kodokage/RAMER-Project/Docs/Ramer_units_Ip.md

# Ramer 1
Ethernet : 192.168.50.2 <br>
Wlan :  ssh pi@:10.93.160.4 <br>

# Ramer 2
Ethernet : 192.168.50.3

# Ramer 3
Ethernet : 192.168.50.4

Wireless address will change for different wifi connections
