kodokage/RAMER-Project/20260903_160956.jpg

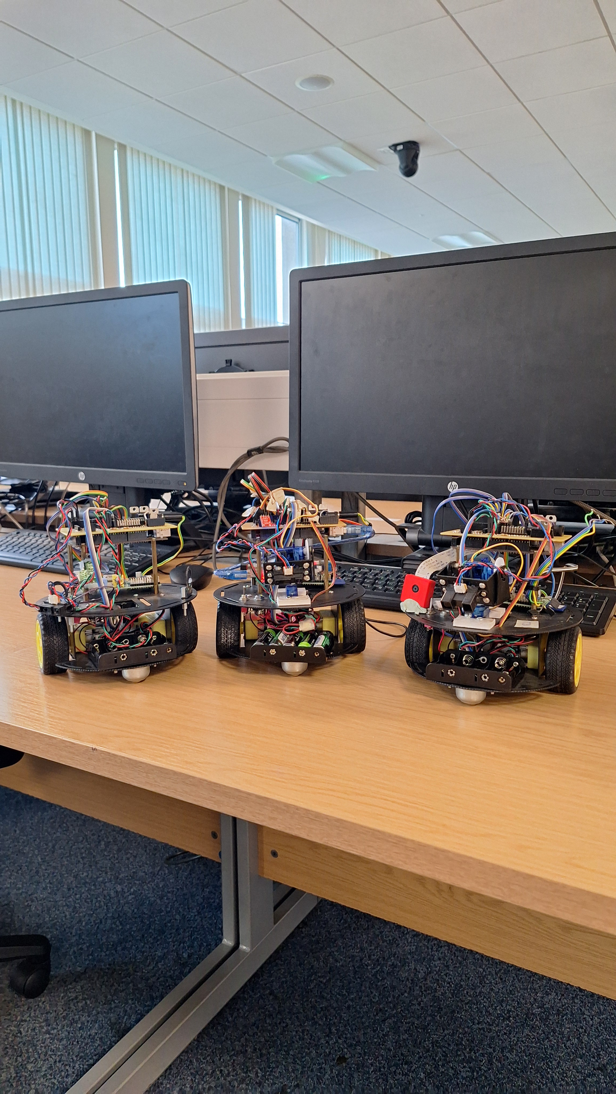
20260903_160956.jpg
