kodokage/RAMER-Project/20260903_161008.jpg

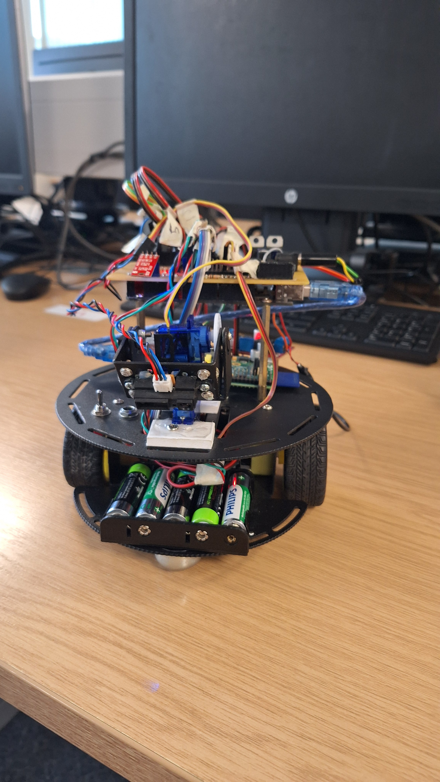
20260903_161008.jpg
