kodokage/RAMER-Project/20260903_161019.jpg

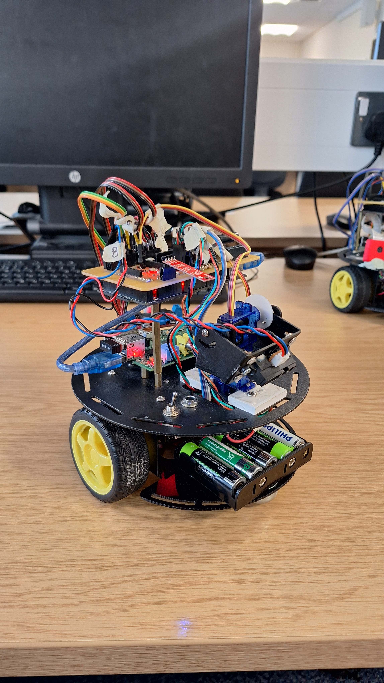
20260903_161019.jpg
