kodokage/RAMER-Project/circuit_diagram.png

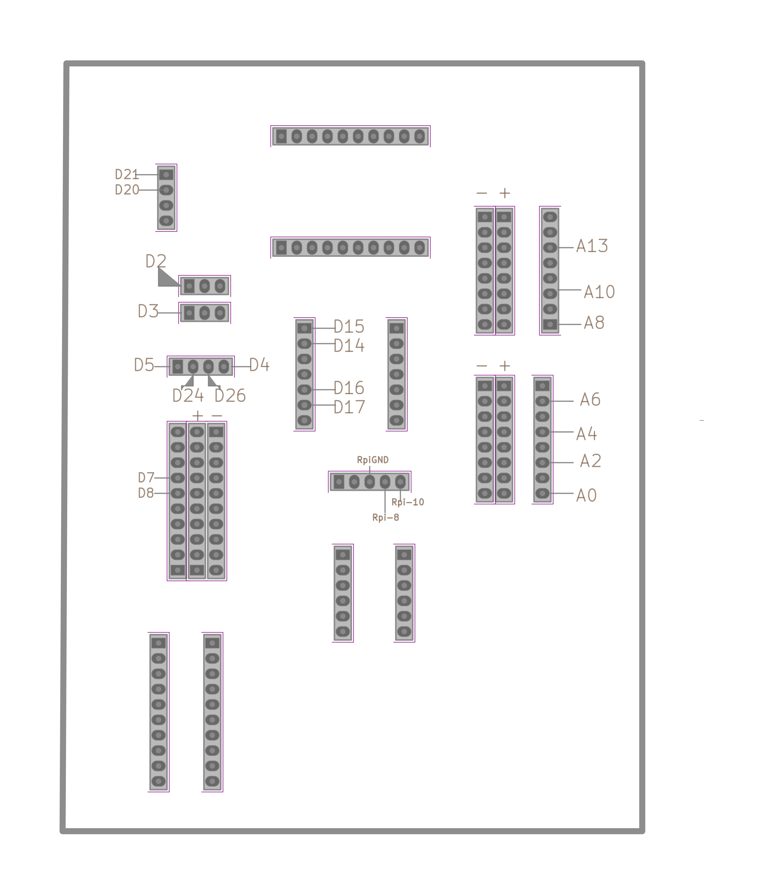
circuit_diagram.png
