kodokage/RAMER-Project/RAMER_Robot_1_1.jpg

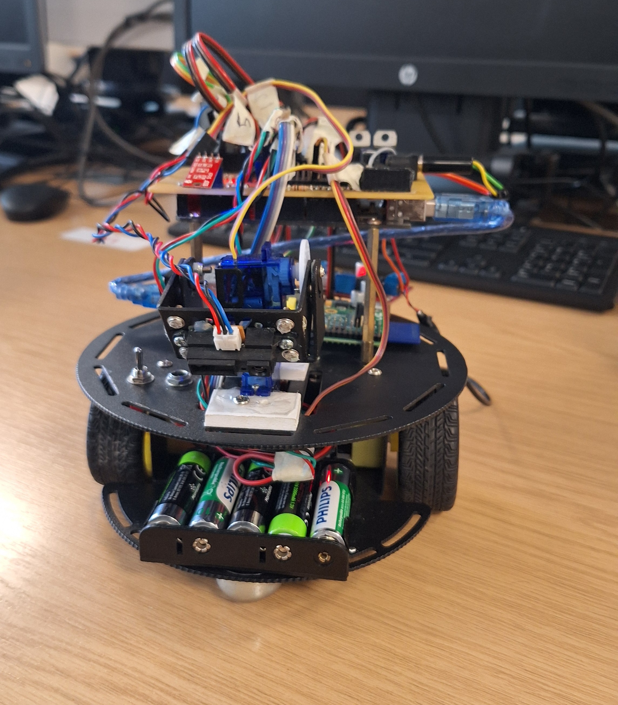
RAMER_Robot_1_1.jpg
