kodokage/RAMER-Project/RAMER_System_Architecture.jpg

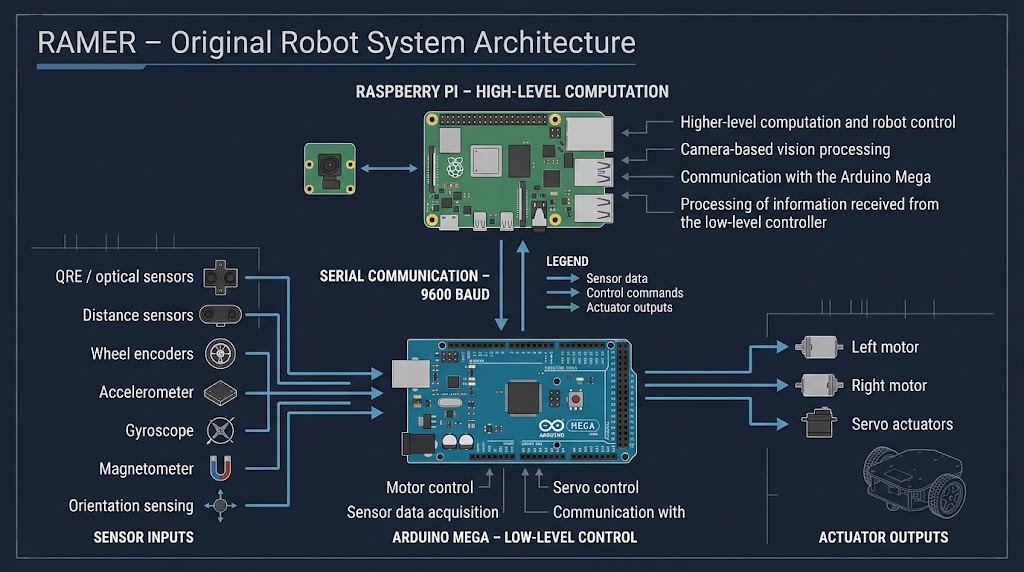
RAMER_System_Architecture.jpg
