kodokage/RAMER-Project/IO_list_BOM.xlsx

Sheet: IO Assignment
S/N | Arduino Mega Pin / Interface | I/O Type | Code Variable | Device | Signal / Function | Configuration / Notes
1 | A0 | Analog input | ir_sensor_1 | QRE1113 #1 | IR line sensor output | analogRead(A0)
2 | A2 | Analog input | ir_sensor_2 | QRE1113 #2 | IR line sensor output | analogRead(A2)
3 | A4 | Analog input | ir_sensor_3 | QRE1113 #3 | IR line sensor output | analogRead(A4)
4 | A6 | Analog input | ir_diode_transistor_1 | OPB706B #1 | IR phototransistor output | analogRead(A6)
5 | A8 | Analog input | ir_diode_transistor_2 | OPB706B #2 | IR phototransistor output | analogRead(A8)
6 | A10 | Analog input | ir_diode_transistor_3 | OPB706B #3 | IR phototransistor output | analogRead(A10)
7 | A13 | Analog input | ir_distance_sensor | Sharp GP2Y0A02YK | IR distance sensor output | ADC converted to distance by sharpDistance()
8 | D7 | Digital output | servo1_pitch | SG90 #1 | Pitch servo control | Servo.attach(7)
9 | D8 | Digital output | servo2_yaw | SG90 #2 | Yaw servo control | Servo.attach(8)
10 | D26 | Digital output | right_motor_fwd | H-bridge / right motor | Right motor direction | HIGH = forward, LOW = reverse
11 | D4 | PWM output | right_motor_speed | H-bridge / right motor | Right motor speed | analogWrite(); +50 software compensation
12 | D24 | Digital output | left_motor_fwd | H-bridge / left motor | Left motor direction | HIGH = forward, LOW = reverse
13 | D5 | PWM output | left_motor_speed | H-bridge / left motor | Left motor speed | analogWrite()
14 | D2 | Digital input / interrupt | right_wheel_encoder | SEN0038 right encoder | Right wheel encoder pulse | INPUT_PULLUP; RISING interrupt
15 | D3 | Digital input / interrupt | left_wheel_encoder | SEN0038 left encoder | Left wheel encoder pulse | INPUT_PULLUP; RISING interrupt
16 | D20 (SDA) | I2C | Wire / IMU | IMU subsystem | I2C data | Wire.begin(); Mega hardware SDA
17 | D21 (SCL) | I2C | Wire / IMU | IMU subsystem | I2C clock | Wire.begin(); Mega hardware SCL
18 | USB / Serial0 | Serial | Serial | Raspberry Pi / host | Command and telemetry interface | 9600 baud

Sheet: BOM
S/N | Item | Description | Qty | Arduino Mega Connection | Pin(s) | Signal / Interface | Code Usage
1 | SG90 9G Micro Servo | 9 g micro servo motor used for pan/tilt positioning. | 2 | Pitch + Yaw servo outputs | D7, D8 | Digital servo control | pitchServo.attach(7); yawServo.attach(8)
2 | Raspberry Pi 2011 | Raspberry Pi Model B used as the higher-level computer/host. | 1 | Serial host interface | USB / Serial0 | Serial | Commands and responses through Serial at 9600 baud
3 | Arduino Mega | Arduino Mega microcontroller used as the main hardware I/O controller. | 1 | Main controller | — | — | Runs R.AM.E.R. firmware
4 | Raspberry Pi camera | Raspberry Pi camera module used for visual sensing and imaging. | 1 | No Arduino I/O in supplied code | — | — | No camera library/interface is implemented
5 | SparkFun QRE1113 Digital Line Sensor Breakout | QRE1113 infrared reflective line sensor breakout used for line/reflective-surface detection. | 3 | Analog sensor inputs | A0, A2, A4 | Analog | analogRead() in sendQRE()
6 | Sharp GP2Y0A02YK IR distance sensor | Sharp GP2Y0A02YK infrared distance sensor used for non-contact distance measurement. | 1 | Analog distance input | A13 | Analog | analogRead() then sharpDistance()
7 | 9 DOF sensor stick LMS9DS1 | LMS9DS1 9-axis inertial sensor containing accelerometer, gyroscope and magnetometer. | 1 | No direct matching sensor driver in supplied code | I2C D20/D21 | I2C | Code actually addresses ADXL345, ITG3200 and HMC5883L
8 | DC-DC voltage converter module | DC-DC voltage converter used to regulate battery voltage for control electronics. | 1 | Power subsystem | — | Power | No GPIO assignment
9 | SD HC card | SDHC memory card used for data/storage or Raspberry Pi operating-system storage. | 1 | No SD interface in supplied code | — | SPI normally | No SD library or chip-select assignment
10 | OPB706B IR diode / phototransistor | OPB706B infrared diode and phototransistor sensor used for optical detection. | 3 | Analog sensor inputs | A6, A8, A10 | Analog | analogRead() in sendOPTO()
11 | Power switch | Power switch used to turn the robot electrical supply on and off. | 1 | Power subsystem | — | Power | No GPIO assignment
12 | 802.11n USB Wi-Fi adapter | 802.11n USB Wi-Fi adapter providing wireless network connectivity. | 1 | Likely Raspberry Pi peripheral | USB | USB | No Wi-Fi code in Mega firmware
13 | SparkFun logic level converter | Logic-level converter used to translate digital signals between 5 V and 3.3 V logic. | 1 | No explicit assignment | — | Level shifting | No dedicated pins defined
14 | Custom PCB | Custom interface PCB used to interconnect the Arduino and peripheral devices. | 1 | Interconnect / interface | — | Various | Firmware does not define PCB connector mapping
15 | L293DNE | L293DNE quadruple half-H motor driver IC used to drive DC motors. | 1 | Motor driver | D24/D5 and D26/D4 | Direction + PWM | Four motor-control signals
16 | Caster wheel | Caster wheel providing passive mechanical support for the mobile robot. | 1 | Mechanical | — | — | No electrical I/O
17 | 5-AA battery pack | 5-AA battery pack providing electrical power to the robot. | 1 | Power source | — | Power | No GPIO assignment
18 | Geared DC motor | Geared DC motors providing drive torque to the robot wheels. | 2 | Motor outputs through H-bridge | D24/D5 and D26/D4 | Direction + PWM | Left/right wheel control
19 | Motor encoder SEN0038 | SEN0038 motor encoder used to measure wheel/motor rotation. | 2 | Interrupt inputs | D2, D3 | Digital pulse | RISING interrupt increments encoder count
20 | H-bridge motor driver | H-bridge motor driver used to control motor direction and speed. | 1 | Motor-control interface | D24, D5, D26, D4 | Direction + PWM | Controls two geared DC motors
21 | Robot chassis | Robot chassis providing the mechanical structure for mounting components. | 1 | Mechanical | — | — | No electrical I/O
22 | 2-inch Robot tyres | 2-inch robot tyres providing traction and motion. | 2 | Mechanical | — | — | No electrical I/O
23 | Wires | Electrical wires used to interconnect power, sensors, motors and control electronics. | lot | Interconnects | — | — | Used throughout hardware
